mabamano/WRO_2026-RoboVanguard/v-photos/back-view.jpeg

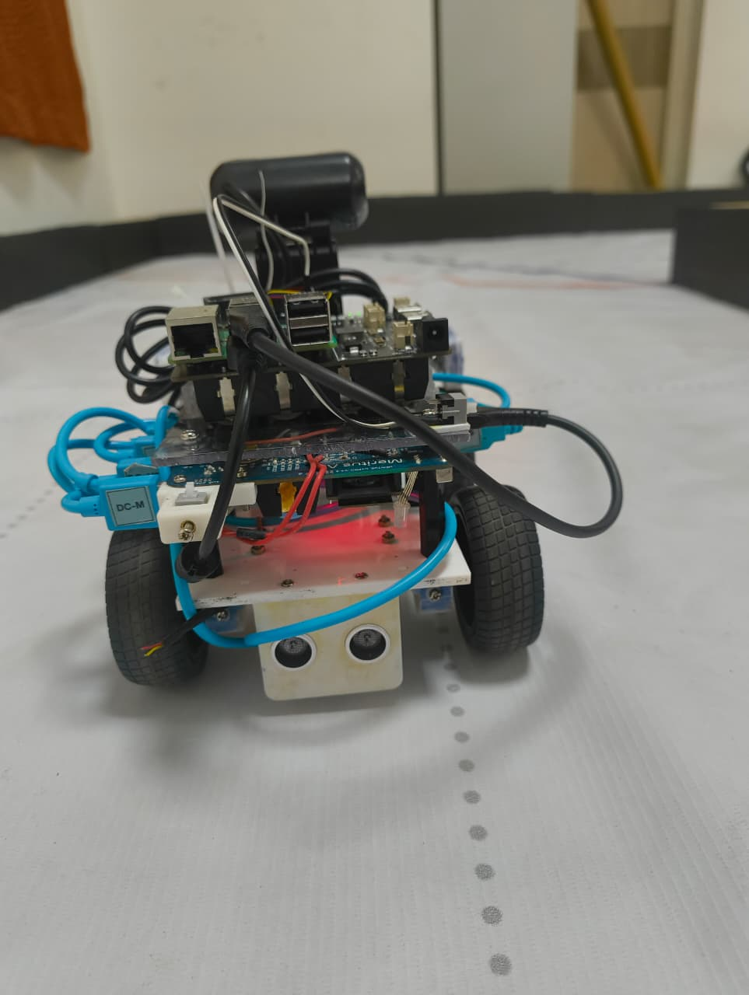
v-photos/back-view.jpeg
