mabamano/WRO_2026-RoboVanguard/v-photos/right-view.jpeg

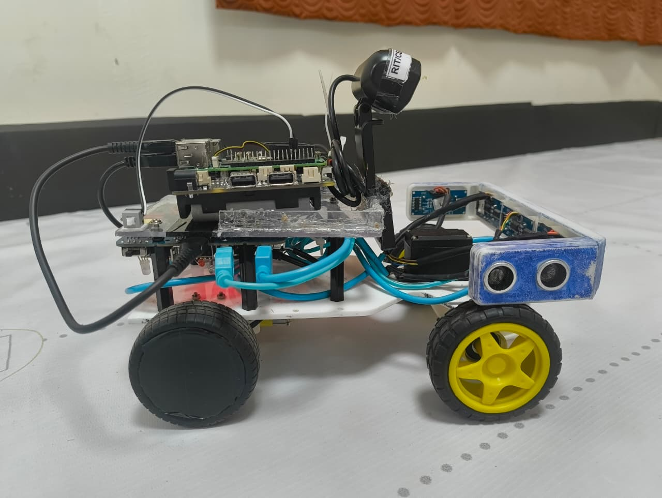
v-photos/right-view.jpeg
