mabamano/WRO_2026-RoboVanguard/v-photos/README.md

# Vehicle Photos (`v-photos/`)

This directory contains six high-resolution perspective photographs of the **ROBOVANGUARD** autonomous vehicle, displaying the mechanical construction, USB Webcam placement, ESP32 controller, DFRobot UPS power hat, and sensor array.

---

## 📸 Image Inventory

1. **[`top-view.jpeg`](file:///c:/Users/mabam/OneDrive/Desktop/WRO2026/WRO-repo/WRO_2026-RoboVanguard/v-photos/top-view.jpeg)**: Top perspective showing Raspberry Pi 5, the DFRobot UPS HAT, the ESP32 RoboGuard unit, power cabling, and battery mounts.
2. **[`bottom-view.jpeg`](file:///c:/Users/mabam/OneDrive/Desktop/WRO2026/WRO-repo/WRO_2026-RoboVanguard/v-photos/bottom-view.jpeg)**: Underside view of the 4 mm laser-cut acrylic chassis, motor mounting, and ground clearance (0.8 cm).
3. **[`front-view.jpeg`](file:///c:/Users/mabam/OneDrive/Desktop/WRO2026/WRO-repo/WRO_2026-RoboVanguard/v-photos/front-view.jpeg)**: Front view illustrating Ackermann steering linkages, MG995 servo motor, USB Webcam tilt mount, and 3 front ultrasonic sensors.
4. **[`back-view.jpeg`](file:///c:/Users/mabam/OneDrive/Desktop/WRO2026/WRO-repo/WRO_2026-RoboVanguard/v-photos/back-view.jpeg)**: Rear view showing the dual-shaft BO DC motor, rear ultrasonic sensor, and drive wheels.
5. **[`left-view.jpeg`](file:///c:/Users/mabam/OneDrive/Desktop/WRO2026/WRO-repo/WRO_2026-RoboVanguard/v-photos/left-view.jpeg)**: Left side elevation showing left side ultrasonic sensor, wheel base (280 mm length), and height profile (250 mm).
6. **[`right-view.jpeg`](file:///c:/Users/mabam/OneDrive/Desktop/WRO2026/WRO-repo/WRO_2026-RoboVanguard/v-photos/right-view.jpeg)**: Right side elevation showing right side ultrasonic sensor, TCS34725 color sensor mount, and wiring harnesses.
