mabamano/WRO_2026-RoboVanguard/video/README.md

# Demonstration Video (`video/`)

This directory contains the official autonomous performance demonstration video of **ROBOVANGUARD**.

---

## 🎥 Video Contents & Requirements

* **Local Video File:** [`Round1_performance.mp4`](file:///c:/Users/mabam/OneDrive/Desktop/WRO2026/WRO-repo/WRO_2026-RoboVanguard/video/Round1_performance.mp4)
* **Duration:** > 30 seconds uninterrupted continuous autonomous navigation run.

---

## 🚗 Performance Demonstration Features

1. **Open Track Run (Round 1):** Continuous lane keeping, black wall distance tracking, corner steering, direction indicator recognition (orange/blue), and 3 complete laps without hitting the walls.
