mabamano/WRO_2026-RoboVanguard/t-photos/README.md

# Team Photos (`t-photos/`)

This directory contains official and candid photographs of team **ROBOVANGUARD** from Ramco Institute of Technology participating in WRO Future Engineers.

---

## 📷 Photos Inventory

* **[`team-pic-candid.jpeg`](file:///c:/Users/mabam/OneDrive/Desktop/WRO2026/WRO-repo/WRO_2026-RoboVanguard/t-photos/team-pic-candid.jpeg)**: Candid moment photo featuring team members during vehicle development, hardware tuning, and code assembly.

---

## 👥 Team Roster

* **Mentor:** Dr. S. Valai Ganesh (Assistant Professor Senior Grade, Mechanical Engineering)
* **Software Lead:** Manojkumar M (CSBS 4th Year)
* **Mechanical Lead:** Amrishi Ram Kumar (Mechanical 4th Year)
