mabamano/WRO_2026-RoboVanguard/t-photos/team-pic-candid.jpeg

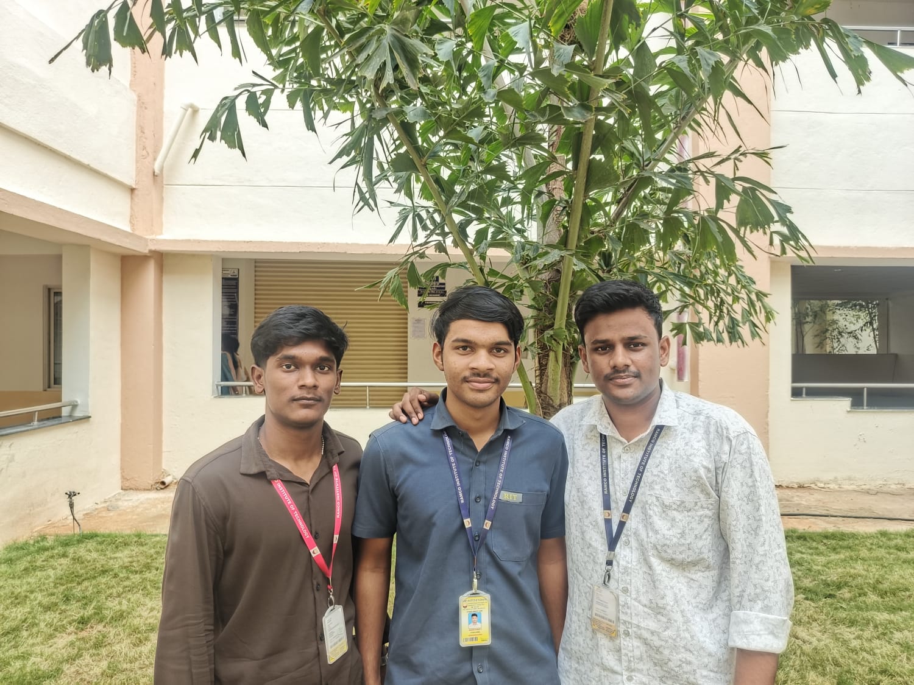
t-photos/team-pic-candid.jpeg
