mabamano/WRO_2026-RoboVanguard/v-photos/front-view.jpeg

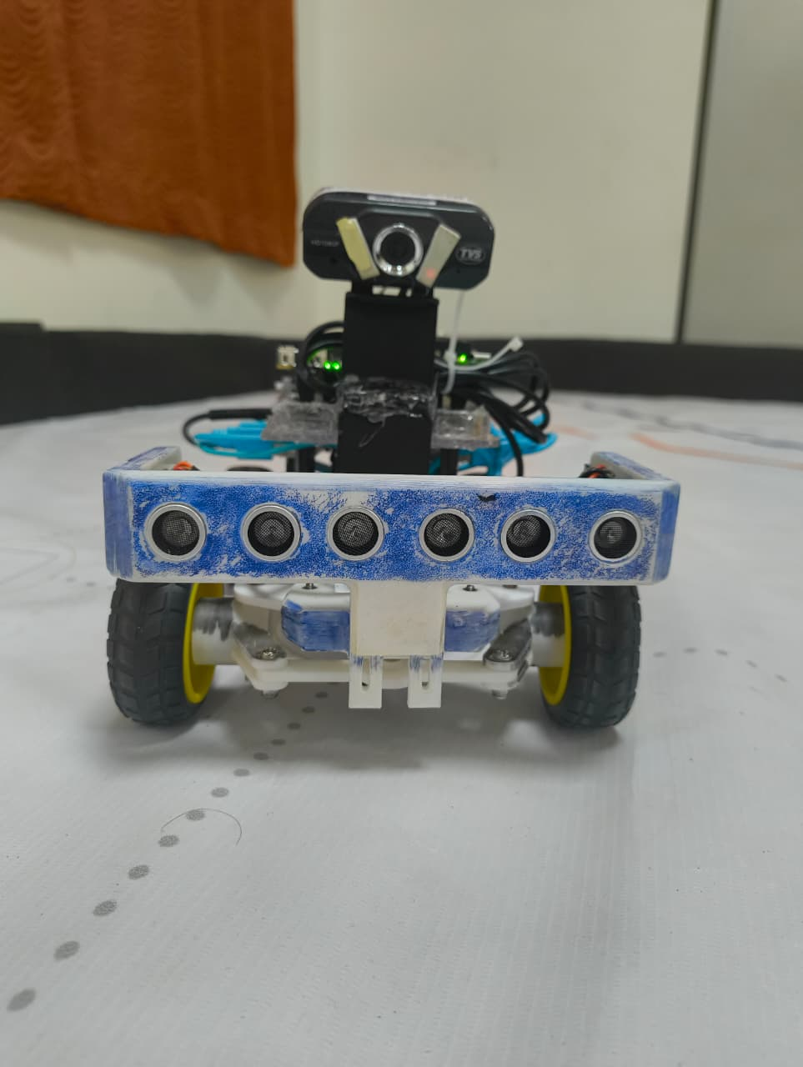
v-photos/front-view.jpeg
