mabamano/WRO_2026-RoboVanguard/v-photos/left-view.jpeg

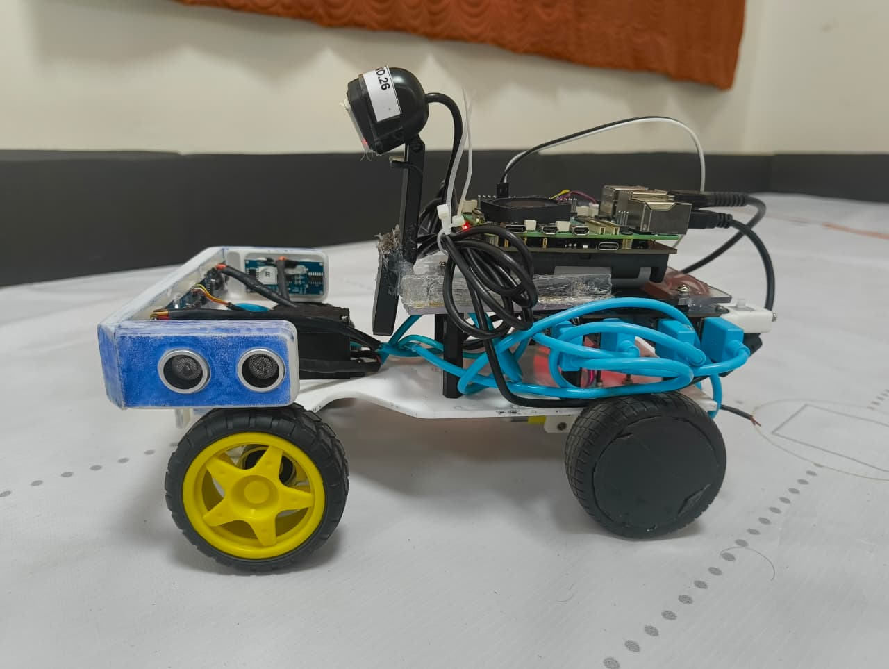
v-photos/left-view.jpeg
